djtremolo/RcBoatController/README.md

[Link to documentation](https://rcboatcontroller.readthedocs.io/en/latest/)
