djtremolo/RcBoatController/doc/photos/blunobeetle.jpg

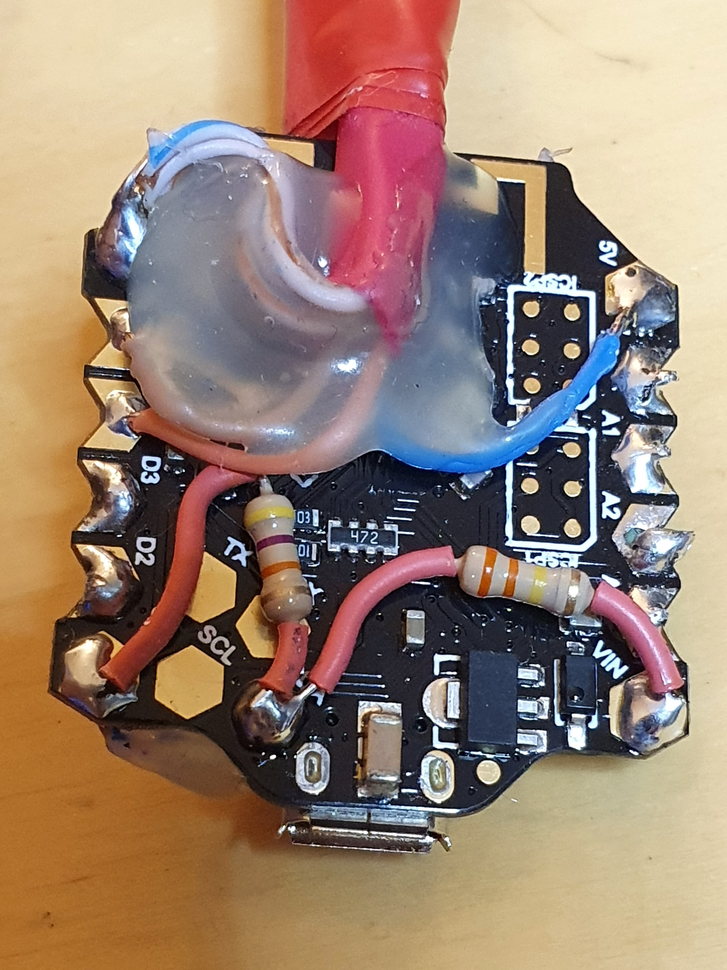
doc/photos/blunobeetle.jpg
