djtremolo/RcBoatController/doc/photos/motorbridgeside.jpg

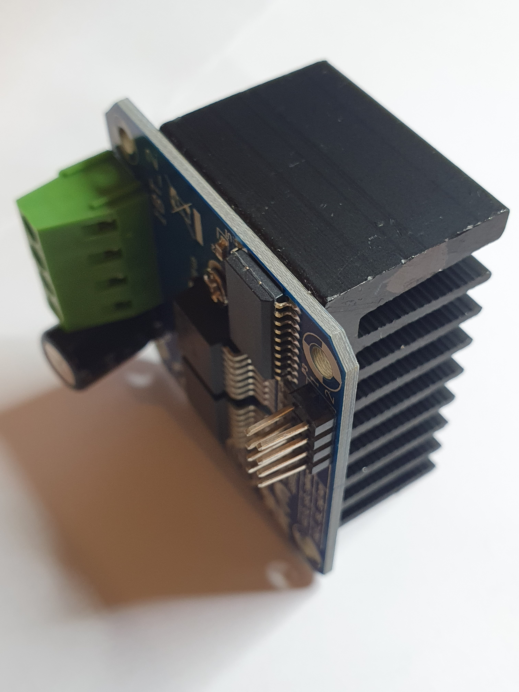
doc/photos/motorbridgeside.jpg
