djtremolo/RcBoatController/doc/photos/motorbridgetop.jpg

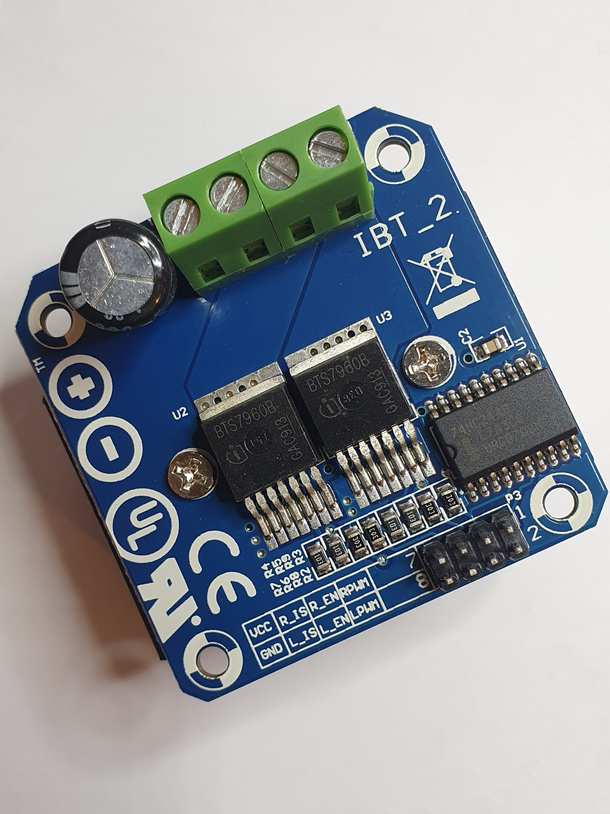
doc/photos/motorbridgetop.jpg
