djtremolo/RcBoatController/doc/photos/mounted.jpg

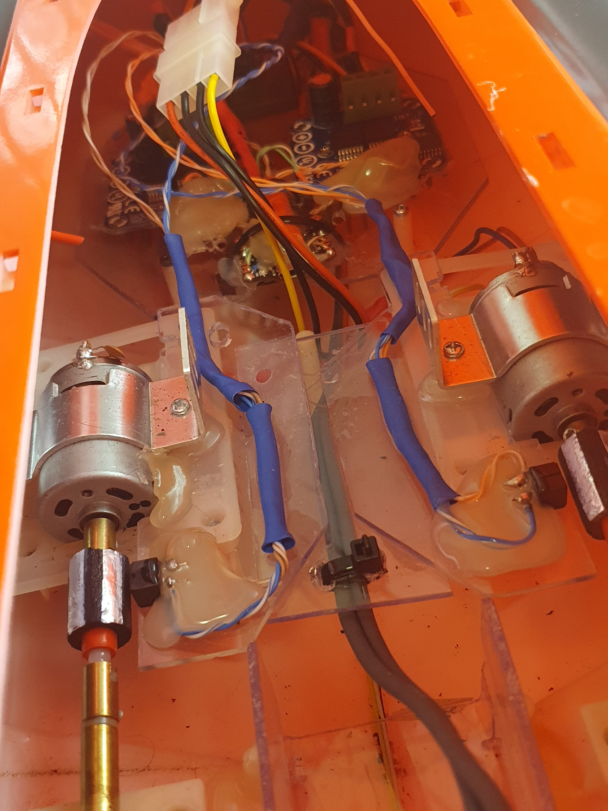
doc/photos/mounted.jpg
