djtremolo/RcBoatController/doc/photos/preview_speeddetector.jpg

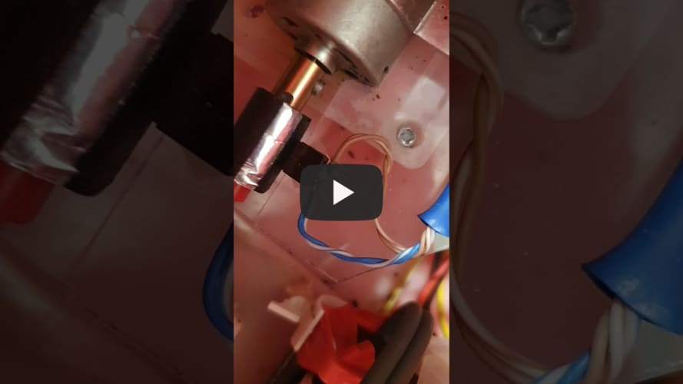
doc/photos/preview_speeddetector.jpg
