djtremolo/RcBoatController/doc/photos/preview_testdrive.jpg

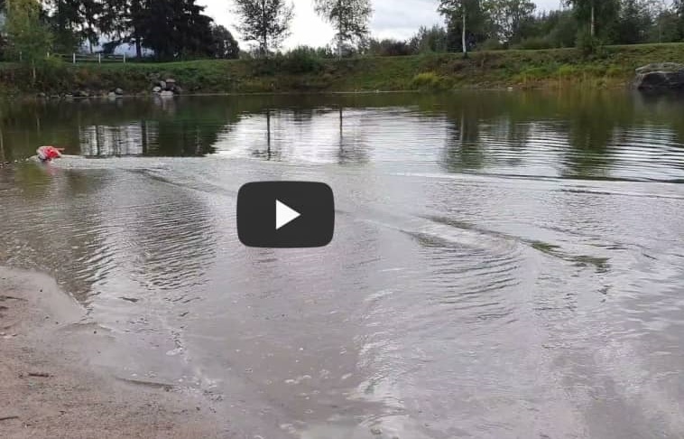
doc/photos/preview_testdrive.jpg
