djtremolo/RcBoatController/doc/schematics/schematic.pdf

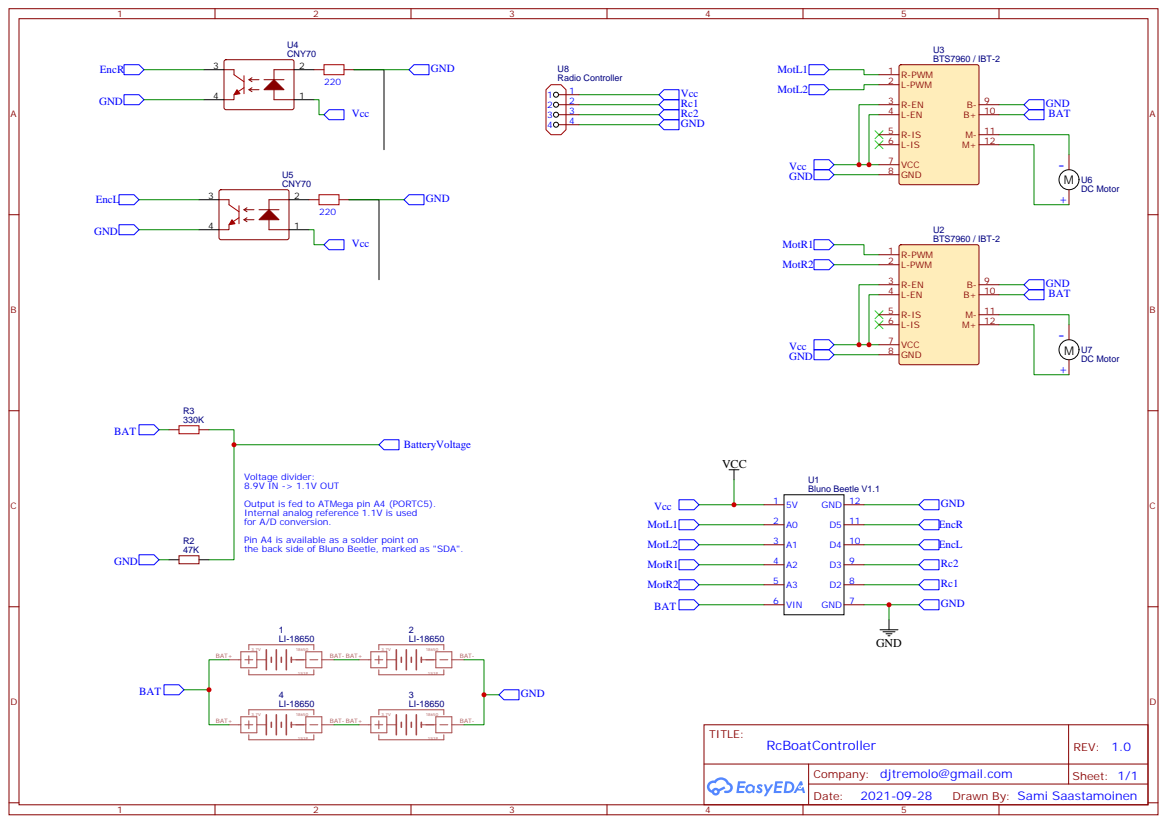
[picture p27: page 1]

Voltage divider:
8.9V IN -> 1.1V OUT
Output is fed to ATMega pin A4 (PORTC5).
Internal analog reference 1.1V is used
for A/D conversion.
Pin A4 is available as a solder point on
the back side of Bluno Beetle, marked as "SDA".

Company: djtremolo@gmail.com

Drawn By: Sami Saastamoinen
