djtremolo/RcBoatController/(commit log)

2021-08-12 removed softtimer, implemented pwm output using 256 step at 8kHz (16ms cycle)
2021-08-15 driving mode changed to drive+brake instead of drive+coast as suggested in DRV8871 data sheet
2021-08-16 pretty much working elements. 16kHz timer takes too much cpu time, first round optimization done, more needed.
    [RCBoatController.ino]
2021-08-16 second round of timer isr optimization: 64->48us
2021-08-16 timer2 isr squeezed to 7us, rc receiver isr to 9us
2021-08-22 changed the pwm output to be independent between motors, with flexible switching frequency. The problem is that DRV8871 is not able to drive the motors and the protection goes off. Will try stronger 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
    [RCBoatController.ino]
2021-08-27 PWM generation changed radically. The switching frequency is now dynamic and independent to both motors. The motor driver hw changed to IBT_2 (>40A vs 3.6A of DRV8871).
2021-08-30 works OK. timer at 30kHz, PWM switching freq 1.5KHz...300Hz
2021-09-05 first version of sensor based speed adjustment pretty much working. TODO: change motor percents to decipercents for accuracy, RC input filtering as the values seem to be noisy.
2021-09-05 speed adjust behaviour improved (at least on slow speeds). To be cleaned. TODO: RC input averaging/filtering?
2021-09-05 comment about what to do for RC input filtering
2021-09-07 improved - not working yet.
    [RCBoatController.ino]
2021-09-16 moved analog reference setting to battery monitor
2021-09-21 encoder handling rewritten, behaves much better now. Lot of debug prints added - to be cleaned.
2021-09-29 removed pip reqs as they are not currently needed
