djtremolo/RcBoatController/doc/photos/controlboard.jpg

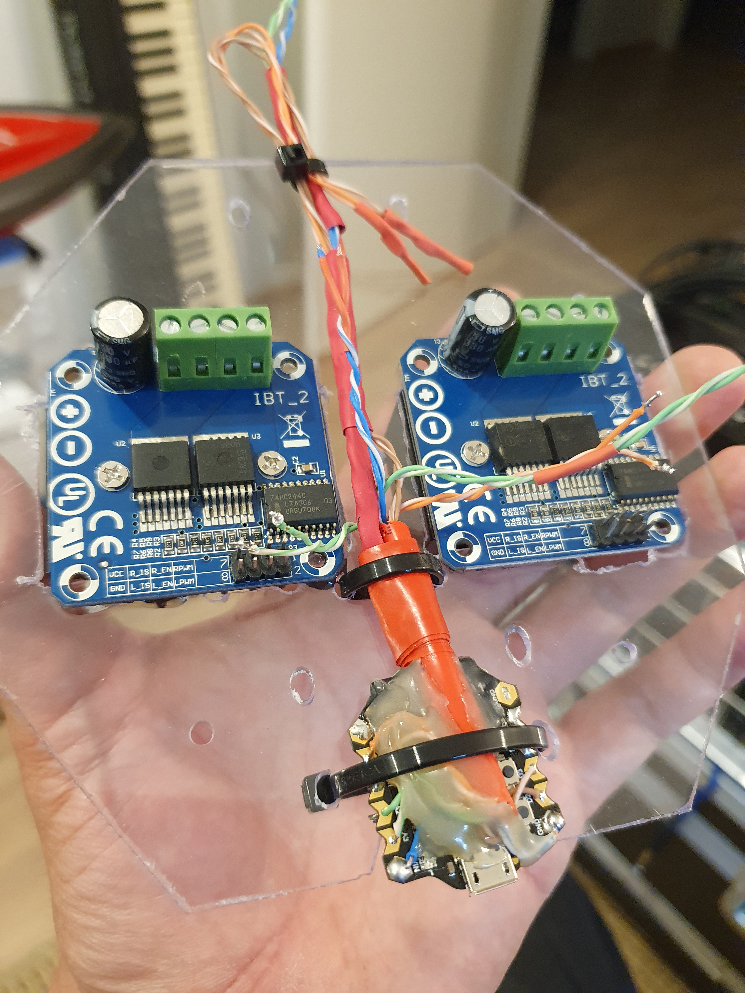
doc/photos/controlboard.jpg
